devfabiosilva/myTeslaSMPS/kicad_project/images/image006.jpg

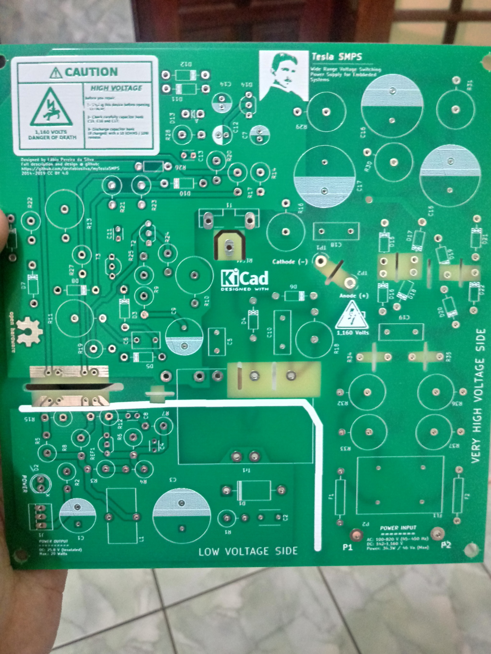
kicad_project/images/image006.jpg
