devfabiosilva/myTeslaSMPS/kicad_project/images/image007.jpg

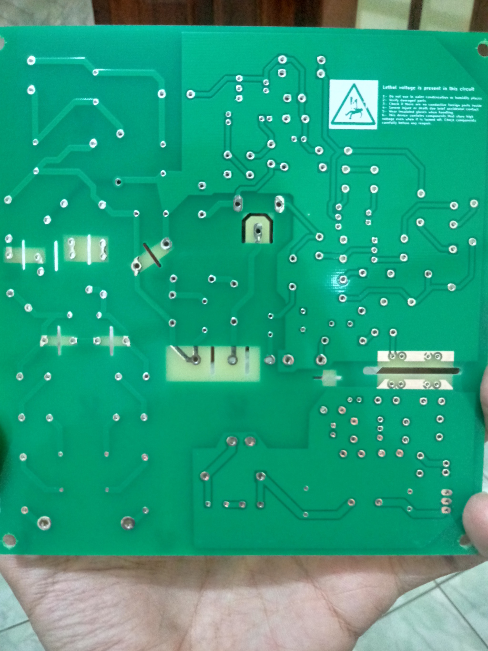
kicad_project/images/image007.jpg
