devfabiosilva/myTeslaSMPS/hi_voltage_design_tips_reference/README.md

## References
 - Removing audible noise in ferrite core [On Semiconductor](https://www.onsemi.com/pub/Collateral/AN-4148.pdf.pdf)
 - Amazing tips through this book ROBERT TARZWELL KEN BAHL (2004) called [HIGH VOLTAGE PRINTED CIRCUIT DESIGN & MANUFACTURING NOTEBOOK](https://www.magazines007.com/pdf/High-Voltage-PCDesign.pdf)
 - Also this amazing youtube video through EEVBlog with Dave testing a medical device made with some insulation requirements for safe operations. See it [here](https://www.youtube.com/watch?v=vfP_65gSSBU)
