devfabiosilva/myTeslaSMPS/article.pdf

Creative Commons
CC BY 4.0

# Wide Voltage Range Tesla SMPS

### da Silva, Fabio Pereira ´

1
*

Abstract

This WVR-SMPS (Wide Voltage Range Switching Mode Power Supply) or simply Tesla SMPS is a wide range and high voltage input for low power embedded systems. This device allows input voltage as low as 100 VAC and as high as 820 VAC in wide frequency range (45−450 Hz) or even in DC voltage as low as 142 VDC and as high as 1,160 VDC

This white paper will show a detailed description and functionality of this circuit. There are only three active elements provinding control, oscillation, positive and negative feedback, short-circuit protection, overload and under-voltage protection.
Keywords
High voltage — SMPS — Tesla SMPS — Wide Range Power Supply — Embedded Power Devices

1Self-taught Engineer, Self-taught Physicist, Self-taght programmer, Hobbyst, Linux Lover, Crypto Lover and Libertarian *Corresponding author e-mail: fabioegel@gmail.com
moto: Veritas lux mea

### Contents

| Introduction | 1
1 | Motivation | 1
2 | Methods and why 25.8 Volts? | 2
2.1 Calculating fmax and fmin switching frequency . . . 3
3 | Measurements and results | 4
4 | Removing audible noise | 5
5 | HV-SMPS Characteristics | 7
6 | Conclusions | 7
| About the author | 7

### Introduction

This device called Tesla SMPS is a wide input voltage range suitable for embedded devices, such as: Sensors, IoT, measurements, embedded control systems.

It’s simply based Flyback topology using only discrete components. In this paper I will show how to build and detailed description for this device that use three active elements only. With three active elements, it’s possible to supply any low power embedded device with wide voltage and frequency range and so you can use it at any industrial and home application devices

### 1. Motivation

I was thinking what could I do to build and design my 8bit Embedded System and any other IoT devices to work at widely universal automotive and home and industry standard voltage into a single system. So I decided to design by myself this device that I called Tesla SMPS using recycled materials

I worked about 3 (three weeks) to design this device and one and half years to improve and fix some problems. After all tests and improvements I’ve found these results below:

1. Supply for low power Embedded System (max. power 20W)
2. Safe high insulation for output voltage (max. 2,600V)
3. Limited inrush current 42.6 A @ 1,160Volts DC (0.38A

2
s)
4. High frequency range in AC operation (45−450Hz)
5. AC/DC operation
6. Static short circuit/overload protection
7. Under voltage protection
8. Low cost components (only 3 active elements!)
9. Startup circuit
10. Limited ID (current drain) monitor
11. Secondary side grounded for security

Wide Voltage Range Tesla SMPS — 2/8

### 2. Methods and why 25.8 Volts?

My first prototype was designed to drive a load with an output voltage of 5 Volts and drive a maximum load of 10 Watts, but I had found one problem.

Due to high current drop in diode and high peak current the efficiency was lower than 60% and the maximum power was 6 Watts only instead of desired 10 Watts.

Using 4 principles of Physics in this circuit I had found an equation to find a good output voltage for maximizing efficiency at full load.

To design the entire circuitry and find a better efficiency at full load the 4 basic principles used are:

1. Faraday0
s Law
2. Law o f Conservation o f Energy
3. Lenz0
s Law
4. Ampere `

0
s Law

Using all principles of Physics above I had designed and I had found a good efficiency for the entire cicuitry. Analysing Flyback topology in Figure 1.

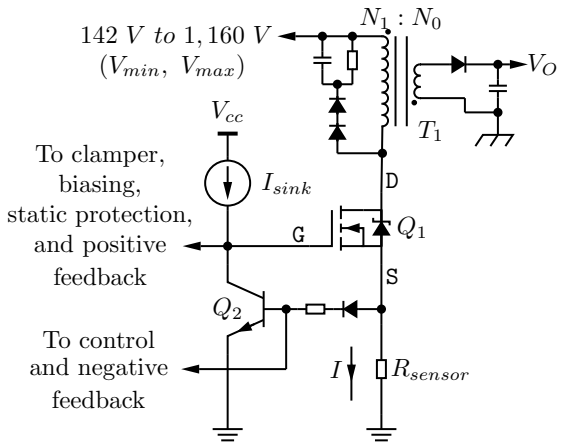
[picture p3: figure]
(Vmin, Vmax); To control and negative feedback; To clamper, biasing, static protection, and positive feedback; Vcc; Isink; Rsensor

Figure 1. Flyback topology in my Tesla SMPS

Let:

I ⇒ the maximum current peak

Vmin ⇒ the minimum voltage of the input circuit

Vmax ⇒ the maximum voltage of the input circuit

V1 | ⇒ input voltage
V0 | ⇒ desired output voltage
N0 | ⇒ number of turn in secondary coil
N1 | ⇒ number of turn in primary coil

Pmin ⇒ minimum output power

Pmax ⇒ maximum output power

T | ⇒ time period of switching
Ton | ⇒ time period on
To f f | ⇒ time period off
D | ⇒ duty cicle
L | ⇒ inductance of the primary coil
η | ⇒ estimated power efficiency

From Faraday0
| s Law¹ we get:
LI = V1Ton | (2.0.1)

From Law o f Conservation o f Energy² we get:

V1Ton = VrTo f f | (2.0.2)

Where Vr

is a reflected output voltage at primary coil when power transistor Q1 is turned off. Vr value is:

Vr = V0

N1
N0

(2.0.3)

Replacing Equation 2.0.3 into Equation 2.0.2 we get:

Ton

To f f

=

V0
V1

×

N1
N0

(2.0.4)

and

D =

1

1+

V1N0
V0N1

(2.0.5)

We know that the average power for a peak current I is:

P =

1
T

×

LI²

2

(2.0.6)

Replacing Equation 2.0.1 into Equation 2.0.6 we get:

P =

1
T

×

V1TonI
2

(2.0.7)

Wide Voltage Range Tesla SMPS — 3/8

We know that:

Ton = DT | (2.0.8)

Replacing Equation 2.0.8 into Equation 2.0.7 we get:

P =

V1I

2

1+

V1N0
V0N1
| (2.0.9)

We put an η (an estimated efficiency of 65%) to adjust 2.0.9 so, the final equation to find a better voltage and a good circuit synthesis is based in this formula based on 4 Physical Principles Laws:

P =

ηV1I

2

1+

V1N0
V0N1
| (2.0.10)

I made some interaction between coil ratio. Given values for 2.0.10 are:

I = 933 mA

Vmin = 142 Volts

Vmax = 1,160 Volts

V0 = 25.8 Volts

N0 = 4 Turns

N1 = 30 Turns

η = 0.65

Replacing into Equation 2.0.10

P(Vmin) = 0.65×142 Volts×933 mA

2

| 1+ 142 Volts×4 Turns

25.8 Volts×30 Turns = Pmin

So

Pmin ≈ 24.83 Watts

And

P(Vmax) = 0.65×1,160 Volts×933 mA

2

1+

1,160 Volts×4 Turns

25.8 Volts×30 Turns = Pmax

So

Pmax ≈ 50.28 Watts

Now we need to know about the maximum voltage in VD (voltage drain). The limitings factors for transistor are:

1. Switching frequency f
2. Maximum drain voltage VD
3. Maximum current drain ID

Calculating fmax and fmin switching frequency
To calculate frequency f let’s use Equation 2.0.1 and 2.0.8 then:

T =

LI
DV1

(2.1.1)

∴

f =

DV1
LI

(2.1.2)

f =

V1
1+

V1N0
V0N1
LI

(2.1.3)

With L = 1.1 mH and replacing all values in Equation 2.1.3 we get a maximum frequency at full load:

fmax =

1,160 Volts
1+

1,160 Volts×4 Turns
25.8 Volts×30 Turns
×1.1 mH ×933 mA

fmax ≈ 161.59 kHz

and

fmin =

142 Volts
1+

142 Volts×4 Turns
25.8 Volts×30 Turns
×1.1 mH ×933 mA

fmin ≈ 79.80 kHz

Calculating VDmax and VDmin
For calculating maximum voltage in transistor drain (VDS)it is necessary to know the voltage in rectified rail (VDC bus) and the reflected voltage of the output voltage (Vr) and (V0).We know that:
VDS = Vr +VDC | (2.2.1)

where:

VDS = V0

N1
N0
+VDC | (2.2.2)

Replacing Equation 2.2.2 with given values we get:

VDSmax = 25.8 Volts×

30 Turns
4 Turns

+1,160 Volts

Wide Voltage Range Tesla SMPS — 4/8

VDSmax = 1,353.50 Volts

and

VDSmin = 25.8 Volts×

30 Turns
4 Turns

+142 Volts

VDSmin = 335.50 Volts

Choosing the transistor
I had found a good transistor 2SK1317 from Renesas website¹ for this application.

In the Table 1 below we can see some characteristics from Renesas datasheet.

Table 1. 2SK1317 Main Characteristics (max. ratings)

| Value | Units
VDS | 1,500 | V
ID | 2.5 | A
Frequency | > 200 | kHz

Analyzing Equation 2.0.10
Analyzing Equation 2.0.10 we can see advantages such as:
1. Increase output power at same range of input voltage
2. Decrease mean current in schottky diode and increase eficiency of my Testa SMPS
3. Easy regulation with higher power
4. Post regulation. Using step-down or step-up circuit regulators this voltage can be easily regulated as low as 3.3 V or 5 V. Standard voltages for microcrontrollers such as Arduino, Raspberry Pi, or as high as 50 V for others purposes.

### 3. Measurements and results

As you can see the results shown in Figure 2 is not acceptable.

After improvements and new re-design of my Tesla SMPS using Equation 2.0.10, new good results and characteristics are shown in Table 2.

1Renesas 2SK1317 datasheet (https://www.renesas.com/us/en/doc/products/transistor/003/rej03g0929_2sk1317ds.pdf)

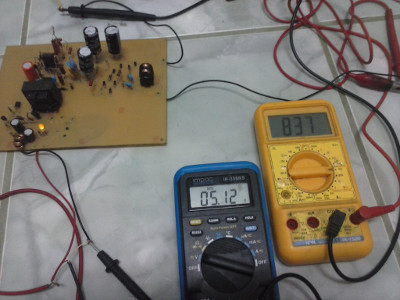
[picture p4: figure]

Figure 2. My first prototype testing before improvements:

Input voltage : 837 VAC @ 60 Hz Out put voltage : 5.12 VDC/6 W

We can also see the measurements in my osciloscope in Figures 3 and 4 below after re-design and improve my Tesla SMPS:

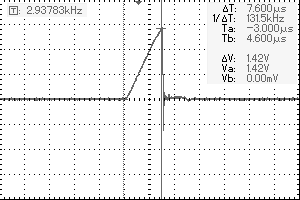
[picture p5: figure]

Figure 3. Peak current I = 946 mA with Rsensor = 1.5 Ω

(500 mV/DIV)
(5 µs/DIV)

Now, with only 3 (three) transistors we can control current, positive and negative feedback, overload and short circuit in primary coil. No integrated circuit is needed to do all this operation. Main focus here is to prove and build with only active and passive elements a very high range input SMPS with recycled materials. Good and acceptable results were found in my project.
Analyzing Figure 4 we can see the control circuit waveform at power transistor gate (VGS). It’s quite different as we expected and you expected a square wave but it’s waveform makes sense. Let’s analyze it step by step.

First of all let’s see Figure 1.

Wide Voltage Range Tesla SMPS — 5/8

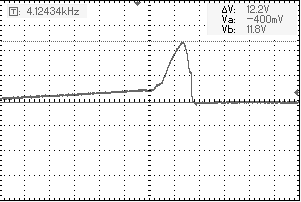
[picture p6: figure]

Figure 4. Peak VGS = 12.2 V

(5 V/DIV)
(5 µs/DIV)

Now dividing information in Figure 4 into 3 parts (A,B and C) and showing in Figure 5 below:

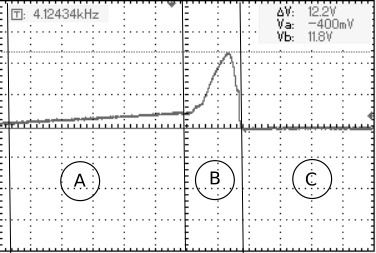
[picture p7: figure]

Figure 5. Peak VGS = 12.2 V

(5 V/DIV)
(5 µs/DIV)

Analyzing A region: In region A (Figure 5), power transistor in Q1 (Figure 1) and transistor Q2 is o f f . Q2 transistor is o f f because there are no current in sensor drain Isensor and output value VO is below threshold voltage reference (negative feedback disabled). Q1 transistor is o f f because positive feedback is disable by voltage applied in the gate is below (Vth ≈ 4 V), where, Vth is threshold voltage of the power transistor Q1. Static protection is enabled only if some atypical behavior (malfunction) occurs. Only current source Isink is driving the gate of Q1. Region A is also known as dead- time, where negative feedback is off and there are no magnetic energy into the transformer core. Decreasing dead-time, we can increase performance increasing output power. Adjusting Isink we could improve swicthing for this application. We can also estimate capacitance including gate and circuitry capacitance using only result obtained from measurements in Figure 4.

Isink = C

dVGS
dt

(3.0.1)

Isink = C

∆VGS
∆t

(3.0.2)

Given values:

Isink ≈ 4.54 mA

∆VGS ≈ 4 V

∆t ≈ 30 µs

∴

C ≈ 34 nF

WhereC is the total capacitance of gate and control circuit.

Analyzing B region: When voltage in VGS reaches threshold voltage (Vth), power transistor begins to inject current in primary coil of the transformer T1. Positive feedback is active at this moment and it forces voltage slope to get higher until it reaches a 12V maximum voltage. Clamper guarantees that the maximum voltage in VGS not exceed 12 V. At this time ID (primary coil current) is linear as shown in Figure 3

Analyzing C region: When voltage through Rsensor in Figure 1 exceeds ≈ 1.4 Volts transistor Q2 turns on forcing voltage gate VGS close to 0 Volt. Control circuit and negative feedback force Q2 base being polarized until all magnetic energy stored in transformer core T1 beeing transfered to secondary circuitry. When all magnetic energy is trasnfered and/or negative feedback is open all process begins a new cycle.

### 4. Removing audible noise

Burst frequency and a high flux peak are the main issue for audible noises.

I had found a good article 2
explaining a good method to reduce this problem. To solve this problem, I had put a RC low pass-filter in voltage reference in secondary side. Decreasing burst switching frequency and its amplitude it is a good way to decrease or even eliminate audio noise when no load is present in the output voltage.

2Audible Noise Reduction Techniques for FPS Applications (https://www.fairchildsemi.com/application-notes/AN/AN-4148.pdf)

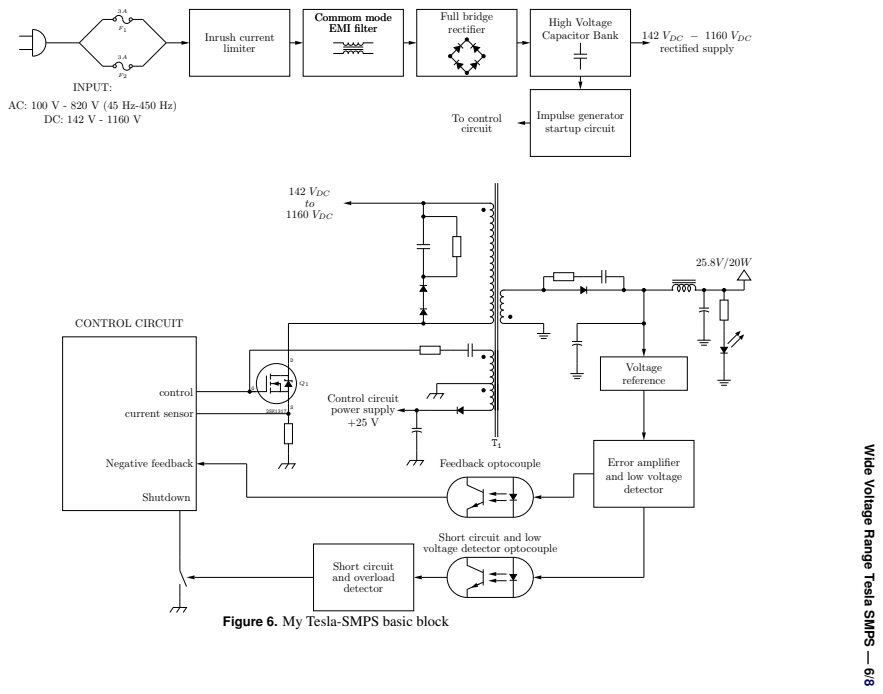
[picture p8: page 6]
Inrush current limiter; Commom mode EMI filter; Full bridge rectifier; High Voltage; Capacitor Bank; VDC; VDC rectified supply; Impulse generator startup circuit; To control circuit; Voltage reference; Feedback optocouple; Control circuit power supply +25 V; Short circuit and overload detector; VDC to 1160; control; current sensor; Shutdown; CONTROL CIRCUIT; Negative feedback; INPUT:

Wide Voltage Range Tesla SMPS — 6/

Error amplifier
and low voltage
detector

Short circuit and low
voltage detector optocouple

Figure 6. My Tesla-SMPS basic block

Wide Voltage Range Tesla SMPS — 7/8

### 5. HV-SMPS Characteristics

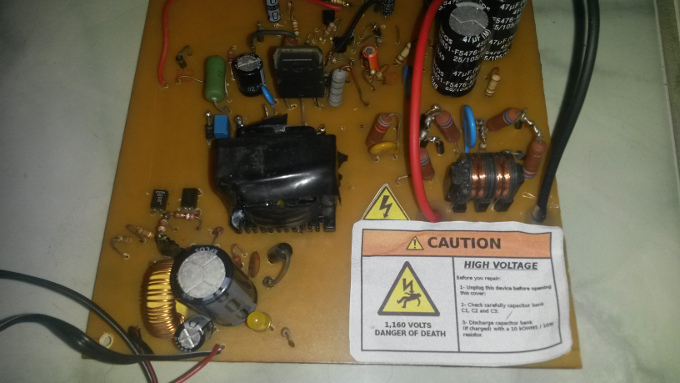
[picture p9: figure]

Figure 7. My sencond and final improved prototype

Table 2. Tesla-SMPS Main Characteristics (max. ratings)

Input Voltage: | AC 100 ∼ 820 Volts
| DC 142 ∼ 1,160 Volts
Output Voltage: | DC 25.8 Volts (Insulated)
Input power (max): | 34.3 W/46 Va
Output power (max): | 20 W
Frequency: | 0 Hz or 45 Hz ∼ 450 Hz
Eficiency: (stimated) | 0.78 @ 180 VDC/127 VAC
| 0.70 @ 500 VDC/350 VAC
| 0.65 @ 1,160 VDC/820 VAC

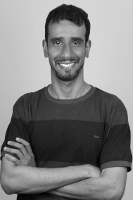
[picture p10: figure]

THD: | 0.75
Insulation: | 2,600 VRMS
Inrush current: | 42.6 A @ 1,160 VDC

I

2
t value @ 1,160 VDC: | 0.38 A
| 2
| s
Primary coil value: | 1.1 mH
Primary coil peak current: | 933 mA

### 6. Conclusions

I’ve made some test with my first automation prototype and other embedded computer. This was quite versatile. So we are able to supply any low power embedded devices to a wide voltage range (industrial/home application). Some photos and real time measurements.

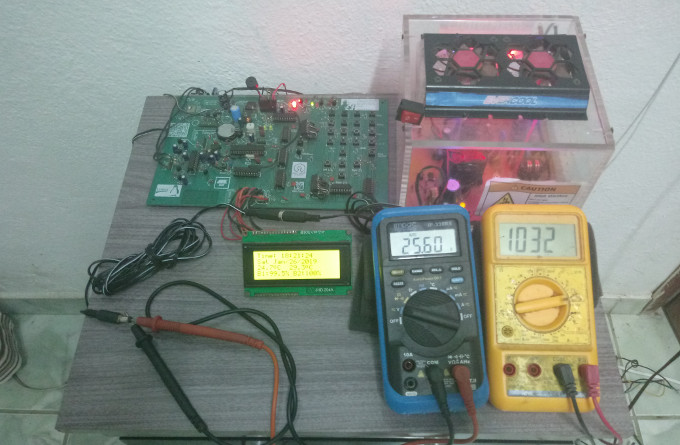
[picture p11: figure]

Figure 8. My embedded working @ 1032Vdc to 25.60 Vdc

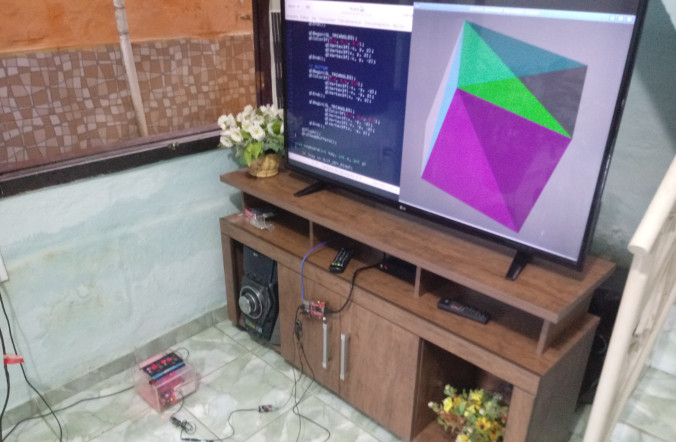
[picture p12: figure]

Figure 9. Linux embedded using my Tesla SMPS

### About the author

Fabio Pereira da Silva ´ | (Rio
de Janeiro, Brazil 1981)
is a self-taught Engineer, Self-taught Physicist, Programmer, Hardware designer, Hobbyist, Linux Lover, Cryto Lover and Libertarian.
I believe voluntarianism and tecnology to increase our acknowledgement and build a
bettter world without any government centralization.
For details, please contact me at fabioegel@gmail.com

Thanks to
Many thanks to http://www.LaTeXTemplates.com for this beautiful LATEX white paper template.

Donations
Please, consider donate any little amount of money.
You can donate with Bitcoin, Litecoin, Nano or even Dogecoin.

Wide Voltage Range Tesla SMPS — 8/8

Bitcoin (BTC)

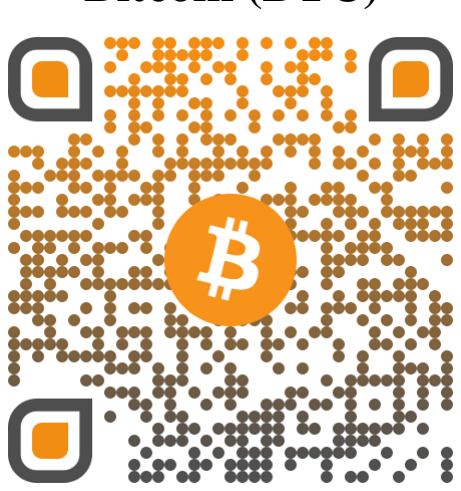
[picture p13: figure]

1JDckpLRJGhp46LTcjY1vsW19wurZ3L1d5

Nano (XRB)

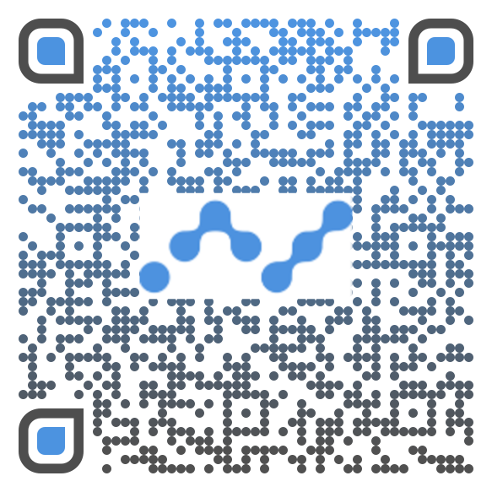
[picture p14: figure]

nano 1cb5fs7xmixqzpitfn9ouy4j1g3hjmdfudc1igt5xhwwps7qdku5htqxmznb

Litecoin (LTC)

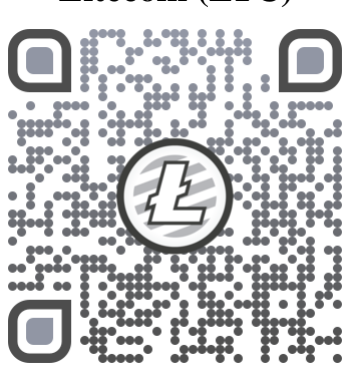
[picture p15: figure]

LRjEiKadFzPCoGorWvSVUnWPsFyPZGt97f

Dogecoin (DOGE)

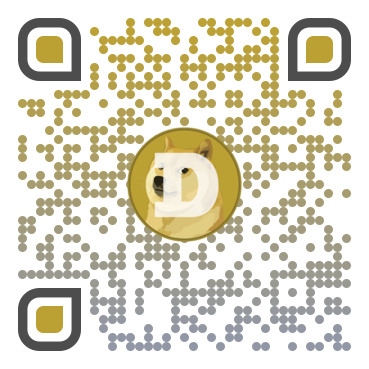
[picture p16: figure]

DRrWWMdwY6AN8rdz7zH2cp3qaK8vSgDTau

Commercial and licenses

This document is under license of Creative Commons 4.0. (https://creativecommons.org/licenses/by/4.0/) You are free to use and share all contents here.

Any question e-mail me at: fabioegel@gmail.com

More details and DIY PCB project are available at my github repository: https://github.com/devfabiosilva/myTeslaSMPS
