devfabiosilva/myTeslaSMPS/kicad_project/images/image001.png

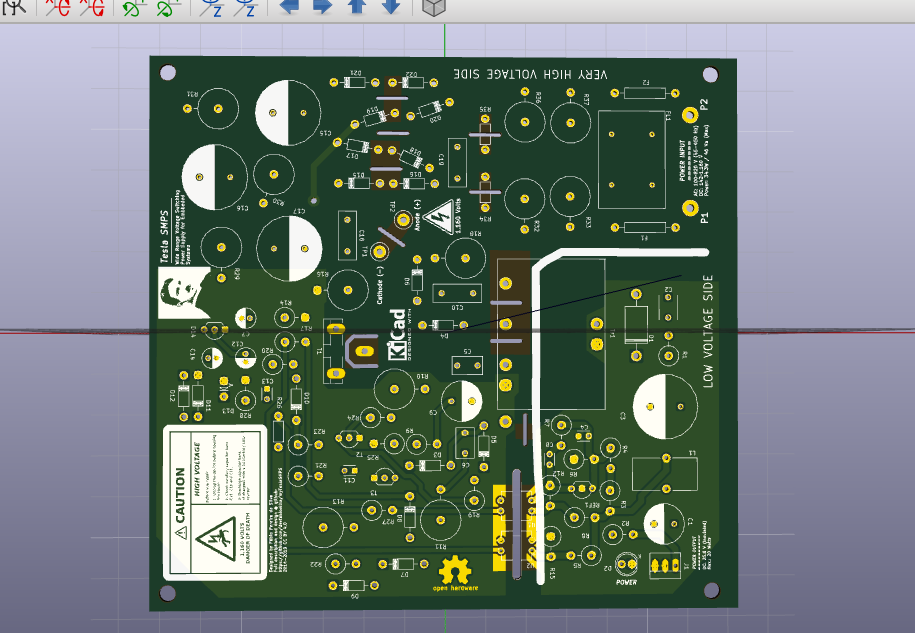
kicad_project/images/image001.png
