devfabiosilva/myTeslaSMPS/kicad_project/images/image002.png

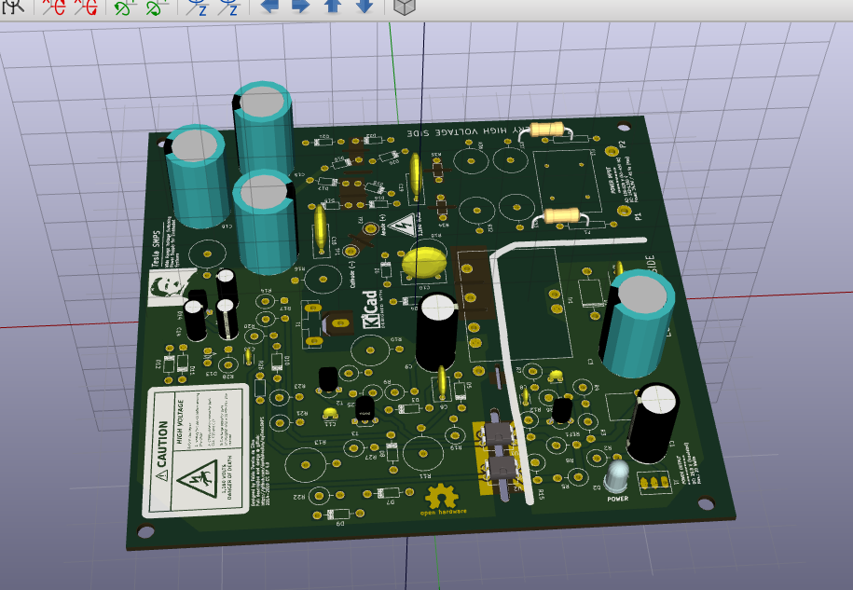
kicad_project/images/image002.png
