devfabiosilva/myTeslaSMPS/kicad_project/images/image003.png

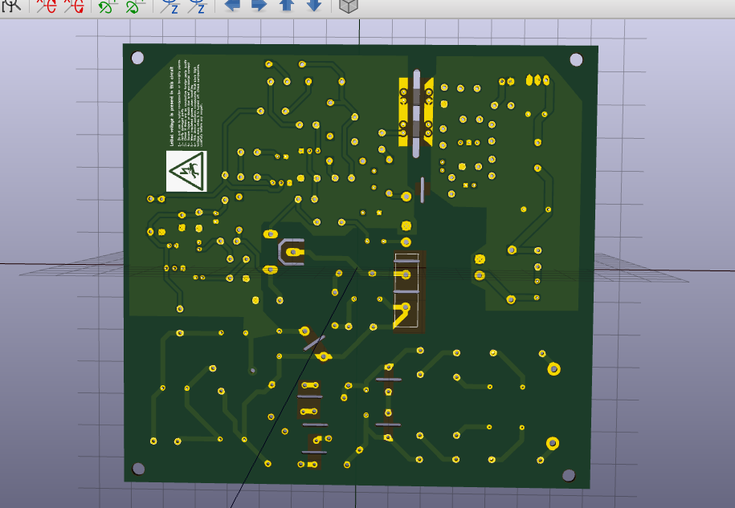
kicad_project/images/image003.png
