devfabiosilva/myTeslaSMPS/kicad_project/images/image004.jpg

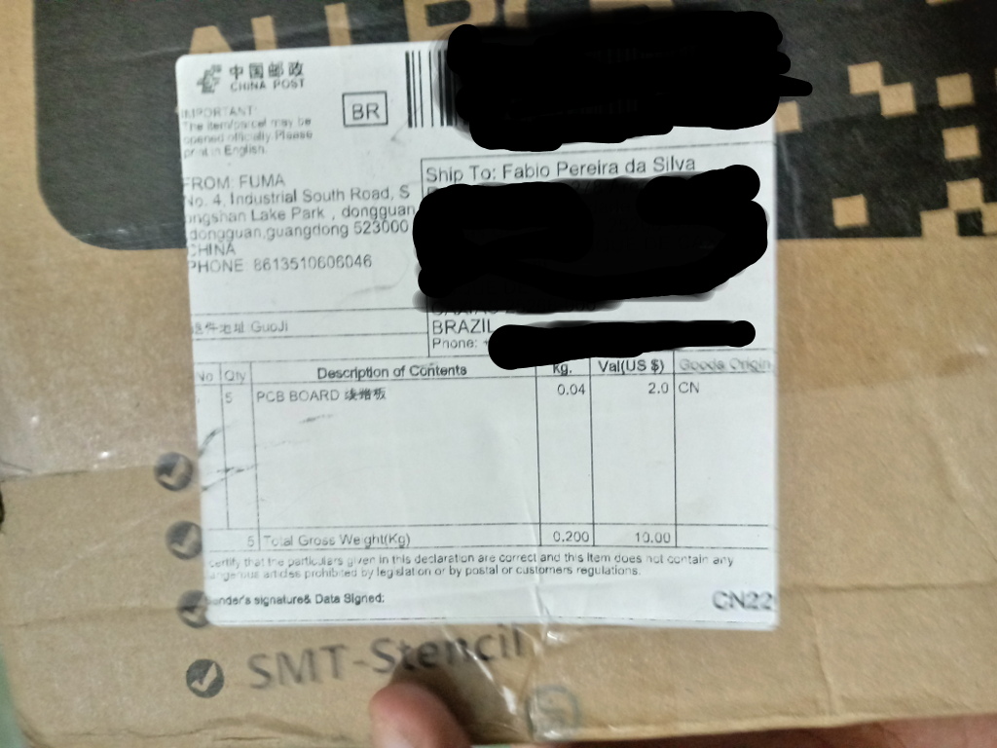
kicad_project/images/image004.jpg
