devfabiosilva/myTeslaSMPS/kicad_project/images/image005.jpg

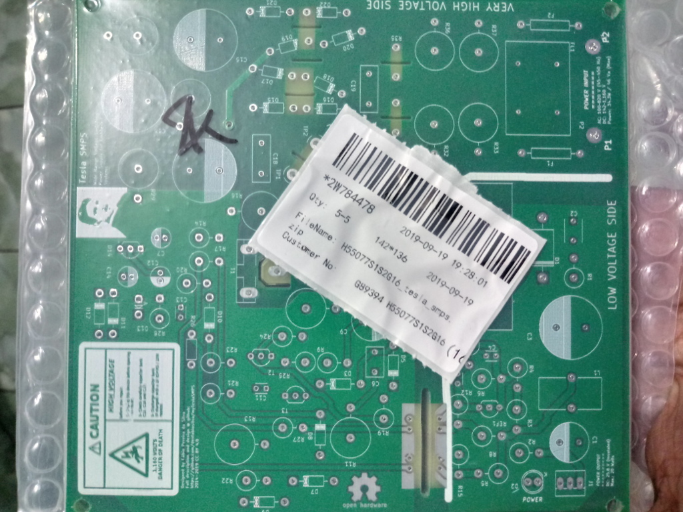
kicad_project/images/image005.jpg
