devfabiosilva/myTeslaSMPS/kicad_project/images/screenshot.png

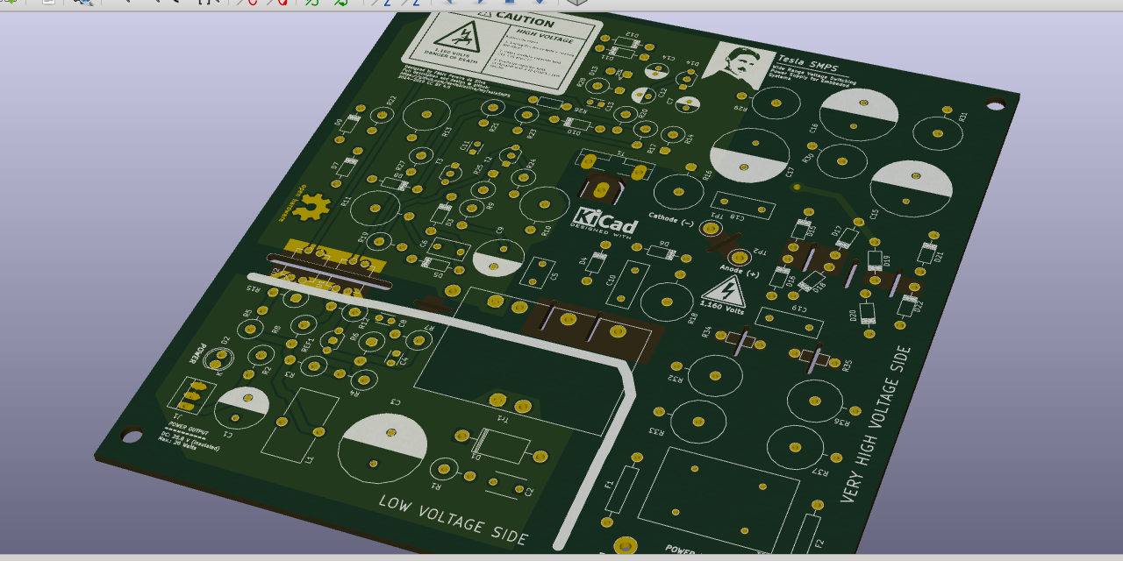
kicad_project/images/screenshot.png
