devfabiosilva/myTeslaSMPS/(commit log)

2018-12-26 Assign and inserting backup file
2019-09-28 Kicad PCB finished
2019-10-07 Add screenshot and waiting my printed PCB arrive from China
2019-10-28 Produced board OK
2020-01-06 Adding old handmade pcb working since 2015
